cdennis3223/BarometerArray/barometer_PCB/mechanical/BarometerHousing.FCStd

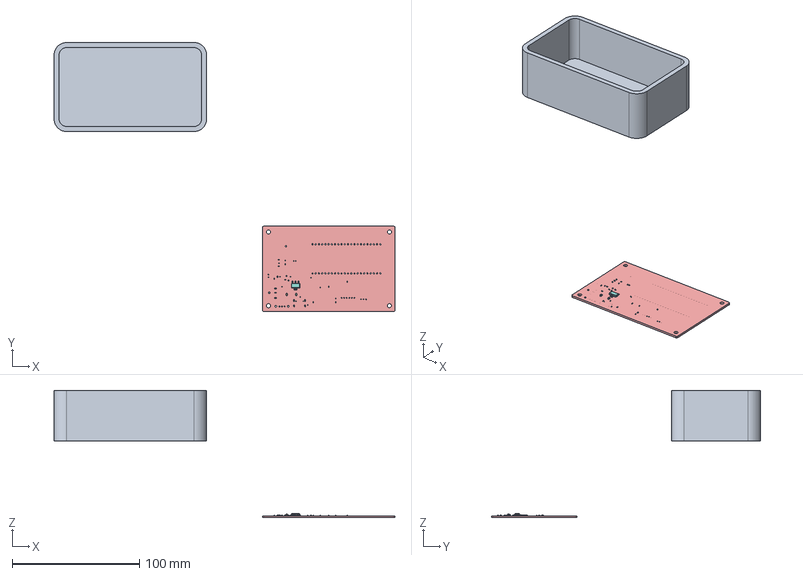
[picture p1: CAD file, 2026-03-30]
barometer_PCB/mechanical/BarometerHousing.FCStd
268.0 x 211.4 x 100.1 mm
R_0402_1005Metric
C_0402_1005Metric
D_SOD-323
R_0402_1005Metric001
C_0402_1005Metric001
R_0402_1005Metric002
R_0402_1005Metric003
R_0402_1005Metric004
LED_0402_1005Metric
C_0402_1005Metric002
R_0402_1005Metric005
C_0402_1005Metric003
R_0402_1005Metric006
C_0402_1005Metric004
SOT-223
R_0402_1005Metric007
R_0402_1005Metric008
C_0402_1005Metric005
R_0402_1005Metric009
R_0402_1005Metric010
R_0402_1005Metric011
L_0402_1005Metric
R_0402_1005Metric012
C_0402_1005Metric006
D_SOD-324
C_0402_1005Metric007
R_0402_1005Metric013
BarometricPressureSensor_PCB
