cdennis3223/BarometerArray/mechanical/Container-Lid.stl

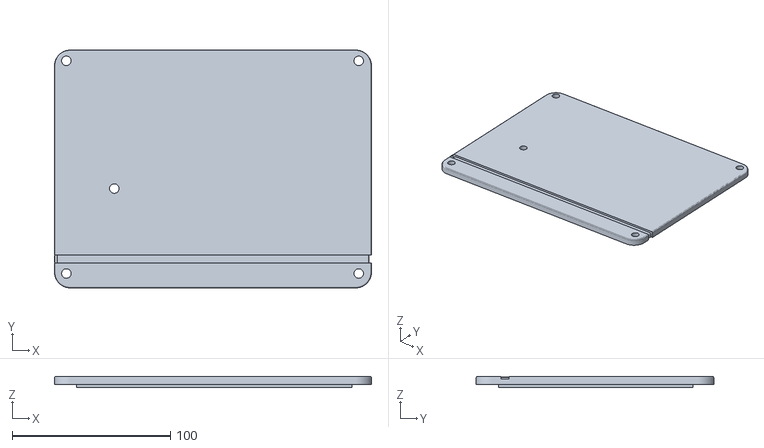
[picture p2: CAD file, 2026-04-27]
mechanical/Container-Lid.stl
200.1 x 150.1 x 7.00
