cdennis3223/BarometerArray/PCB/comp_STEPS/54-00125.step

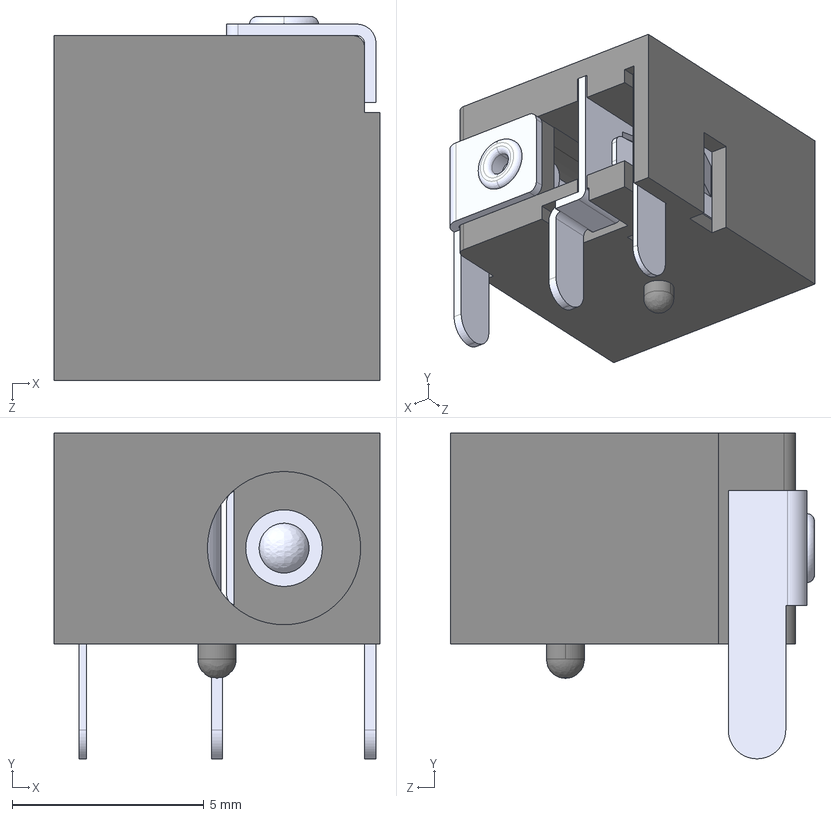
[picture p3: CAD file, 2026-04-01]
PCB/comp_STEPS/54-00125.step
8.50 x 8.50 x 9.50 mm
