cdennis3223/BarometerArray/PCB/PCB.step

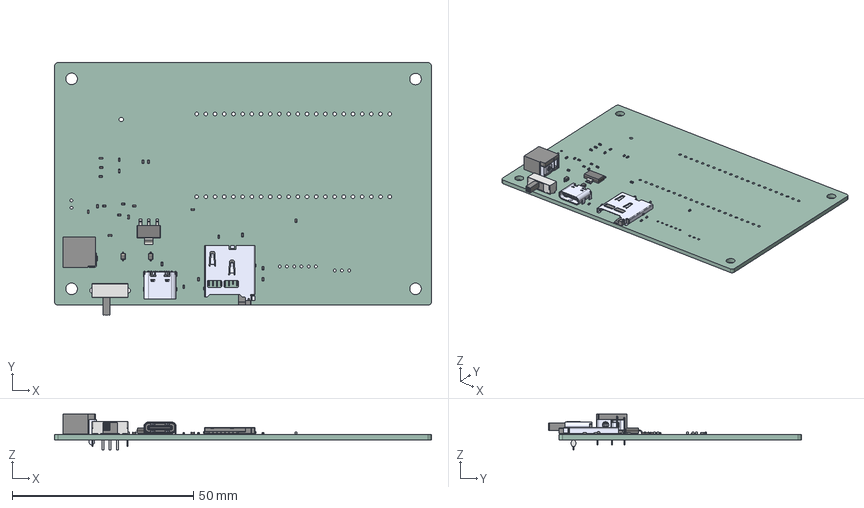
[picture p4: CAD file, 2026-04-01]
PCB/PCB.step
104.1 x 69.9 x 9.90 mm
R_0402_1005Metric x 14
C_0402_1005Metric x 8
D_SOD-323 x 2
LED_0402_1005Metric
GTFP08441BEU
SOT-223
EG1213
L_0402_1005Metric
USB4105GFA_USB4105GFA
BarometricPressureSensor_PCB
