cdennis3223/BarometerArray/PCB/Project Components/B2B_PH_K_S/B2B-PH-K-S.step

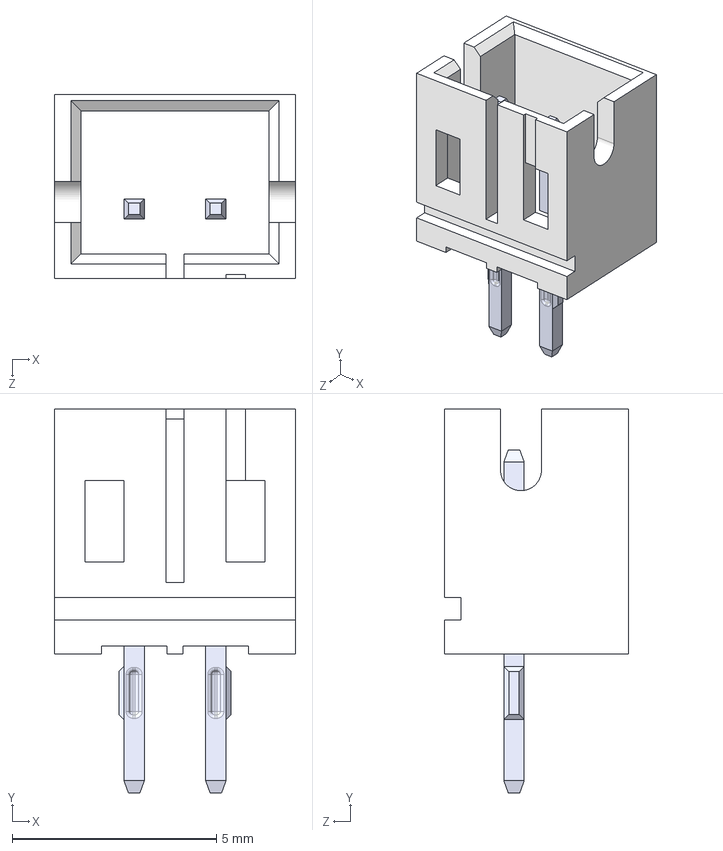
[picture p5: CAD file, 2026-03-30]
PCB/Project Components/B2B_PH_K_S/B2B-PH-K-S.step
5.90 x 9.40 x 4.50 mm
