cdennis3223/BarometerArray/PCB/Project Components/B3B_PH_K_S/B3B-PH-K-S.step

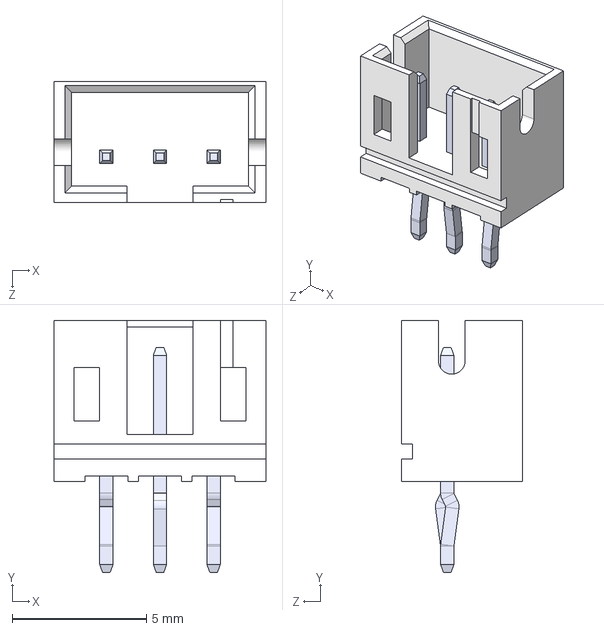
[picture p6: CAD file, 2026-03-30]
PCB/Project Components/B3B_PH_K_S/B3B-PH-K-S.step
7.90 x 9.40 x 4.50 mm
pin x 3
