cdennis3223/BarometerArray/PCB/Project Components/B6B_PH_K_S/B6B-PH-K-S.step

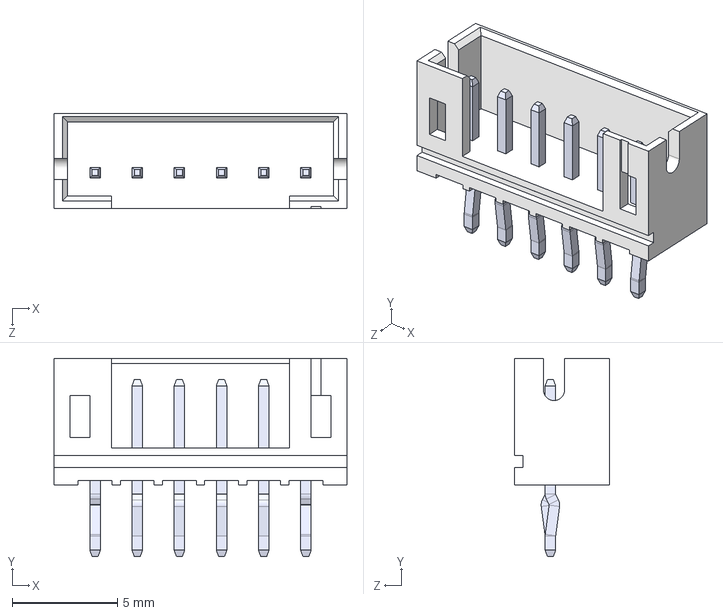
[picture p7: CAD file, 2026-03-30]
PCB/Project Components/B6B_PH_K_S/B6B-PH-K-S.step
13.9 x 9.40 x 4.50 mm
pin x 6
