cdennis3223/BarometerArray/PCB/Project Components/CD-PA1616D/CD-PA1616D.step

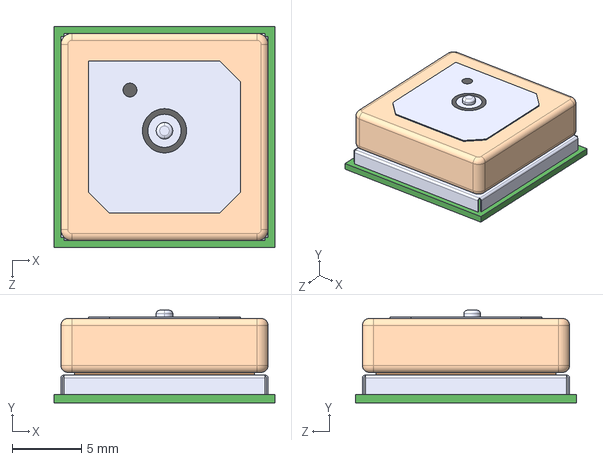
[picture p8: CAD file, 2026-03-30]
PCB/Project Components/CD-PA1616D/CD-PA1616D.step
16.0 x 6.70 x 16.0 mm
