cdennis3223/BarometerArray/PCB/Project Components/DPS368XTSA1/DPS368XTSA1.step

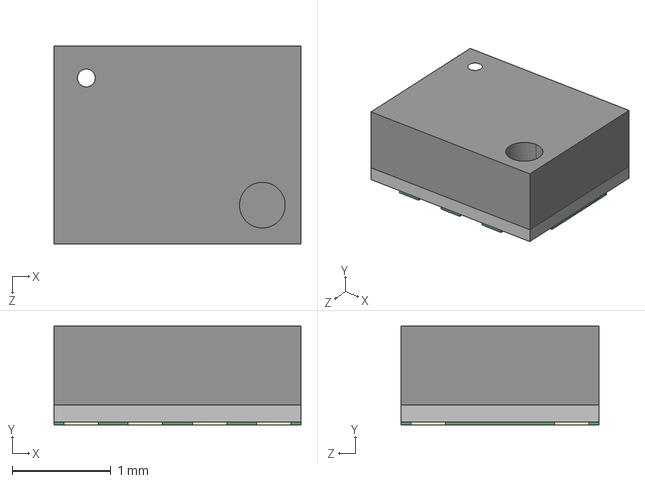
[picture p9: CAD file, 2026-03-30]
PCB/Project Components/DPS368XTSA1/DPS368XTSA1.step
2.50 x 1.00 x 2.00 mm
