cdennis3223/BarometerArray/PCB/Project Components/EG1218/EG1218.step

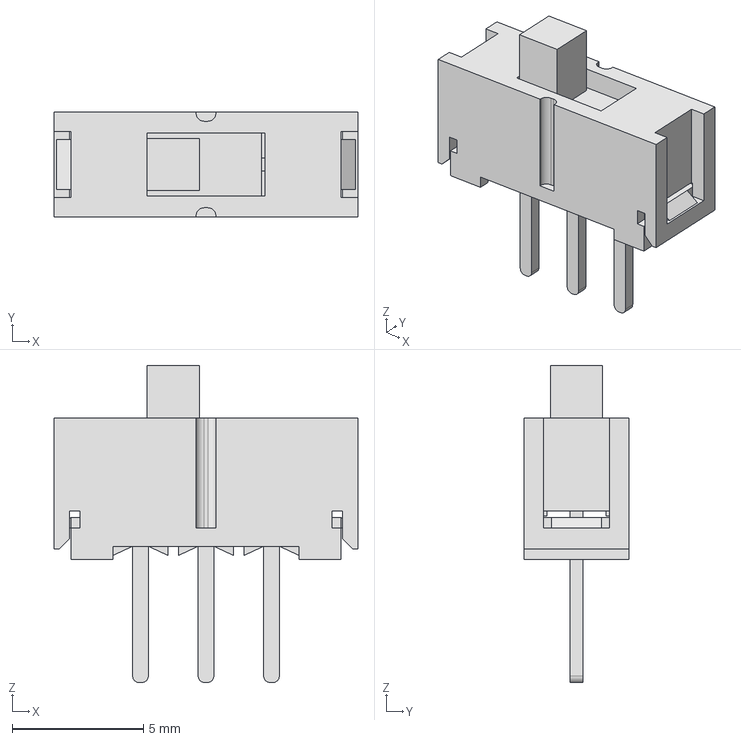
[picture p10: CAD file, 2026-03-30]
PCB/Project Components/EG1218/EG1218.step
11.6 x 4.00 x 12.1 mm
