cdennis3223/BarometerArray/PCB/Project Components/ESP32-S3-DEVKITC-1-N16R8V/ESP32-S3-DEVKITC-1-N16R8V.step

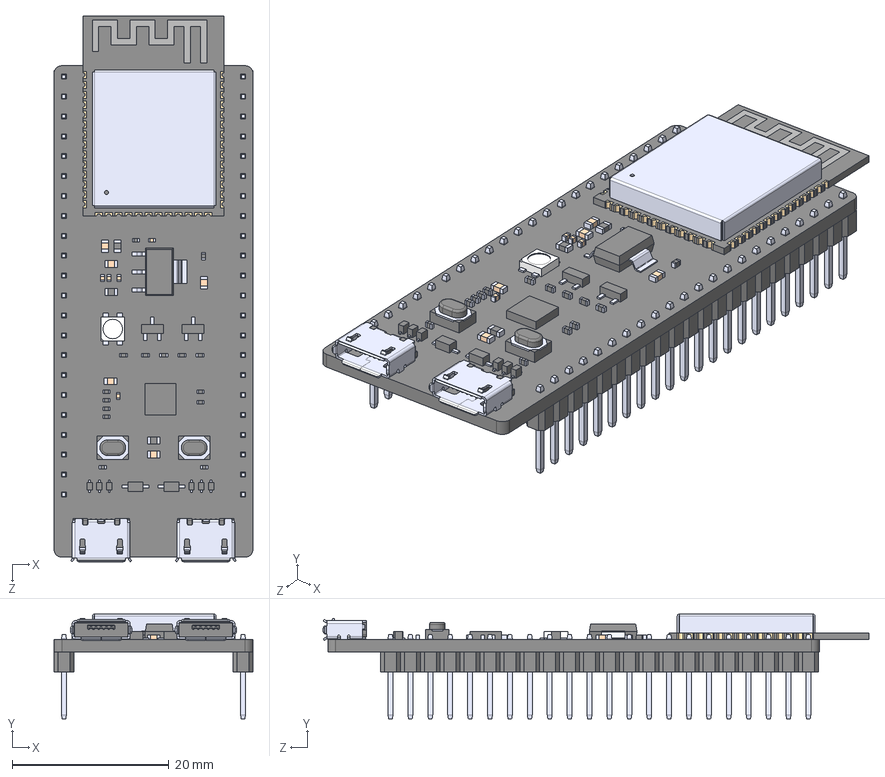
[picture p11: CAD file, 2026-03-30]
PCB/Project Components/ESP32-S3-DEVKITC-1-N16R8V/ESP32-S3-DEVKITC-1-N16R8V.step
25.4 x 13.4 x 69.6 mm
