cdennis3223/BarometerArray/PCB/Project Components/GTFP08441BEU/GTFP08441BEU.step

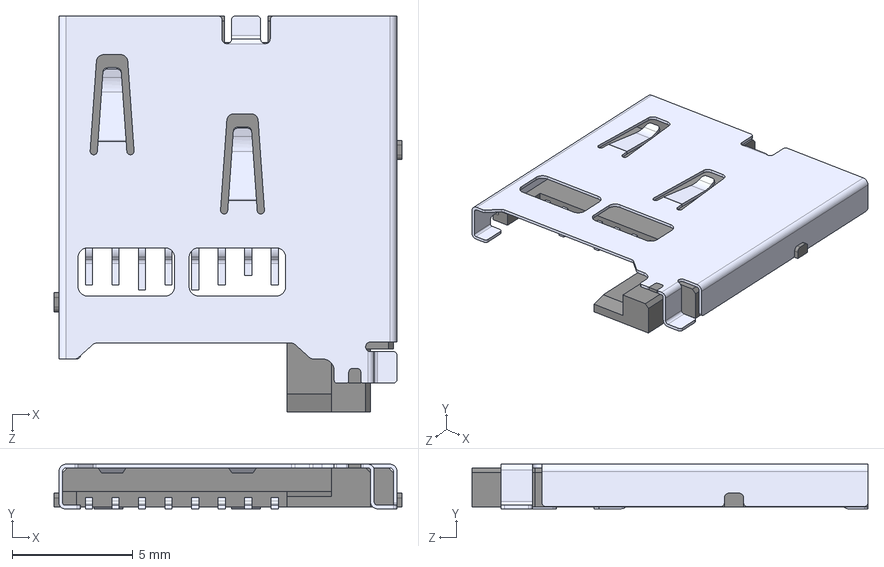
[picture p12: CAD file, 2026-03-30]
PCB/Project Components/GTFP08441BEU/GTFP08441BEU.step
14.4 x 1.85 x 16.4 mm
