cdennis3223/BarometerArray/PCB/Project Components/USB4105_GF_A/USB4105-GF-A.step

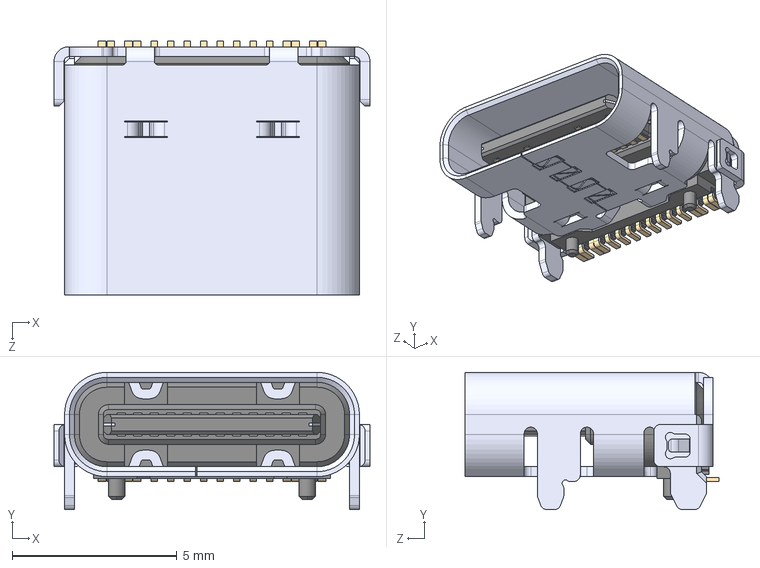
[picture p13: CAD file, 2026-03-30]
PCB/Project Components/USB4105_GF_A/USB4105-GF-A.step
9.58 x 4.16 x 7.71 mm
