cdennis3223/BarometerArray/mechanical/Container.FCStd

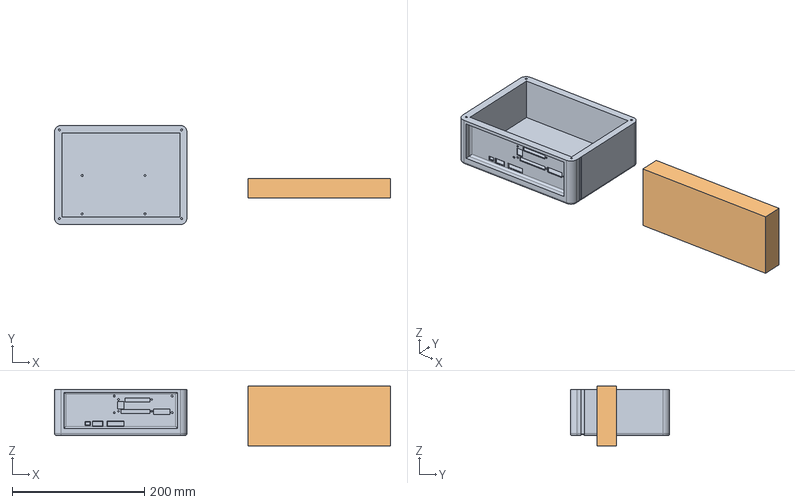
[picture p14: CAD file, 2026-04-27]
mechanical/Container.FCStd
507.5 x 150.0 x 90.0 mm
Container
FrontCap
