cdennis3223/BarometerArray/PCB/comp_STEPS/EG1213.STEP

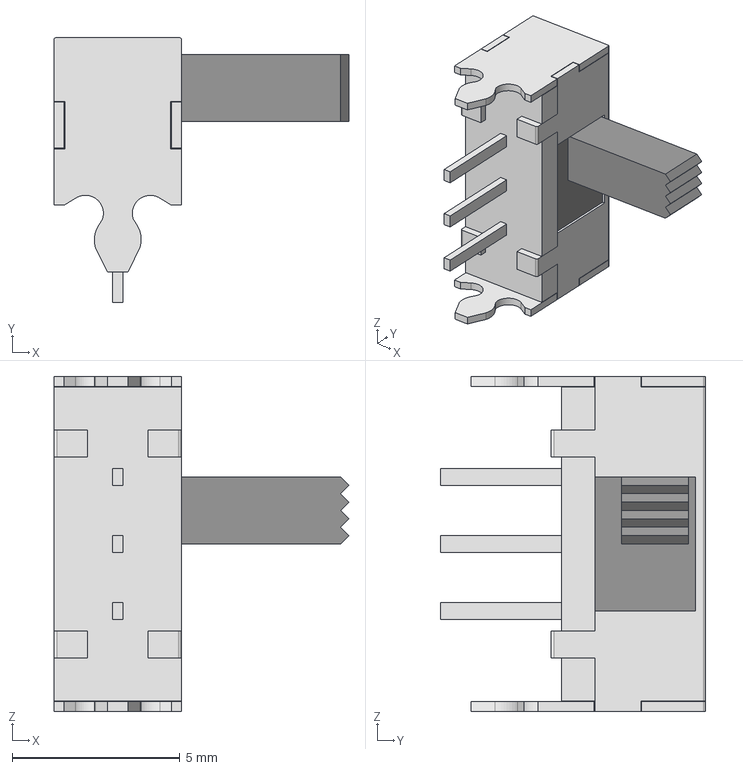
[picture p15: CAD file, 2026-03-30]
PCB/comp_STEPS/EG1213.STEP
8.80 x 7.90 x 10.00 mm
