cdennis3223/BarometerArray/mechanical/Container-Container.stl

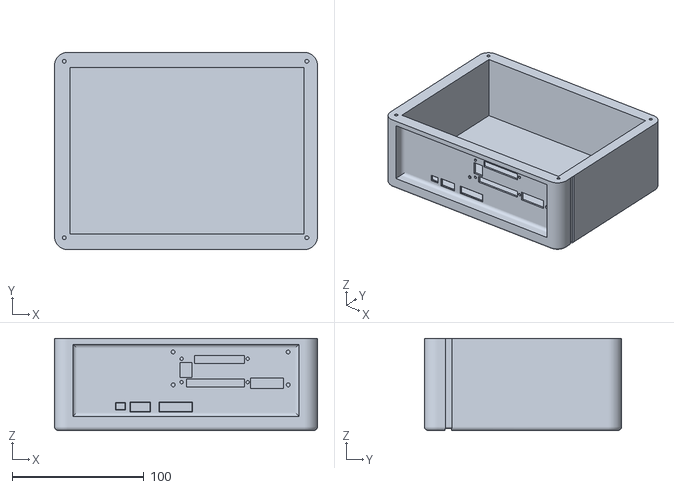
[picture p16: CAD file, 2026-04-27]
mechanical/Container-Container.stl
200.0 x 150.0 x 70.0
