cdennis3223/BarometerArray/PCB/comp_STEPS/USB4105-GF-A.STEP

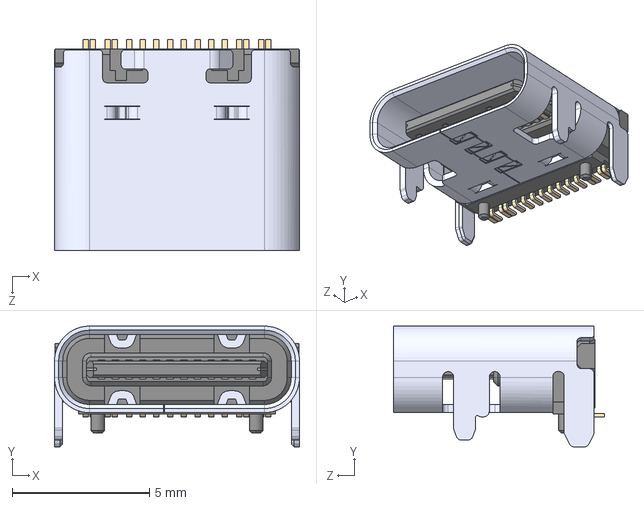
[picture p17: CAD file, 2026-03-30]
PCB/comp_STEPS/USB4105-GF-A.STEP
8.94 x 4.41 x 7.71 mm
