cdennis3223/BarometerArray/mechanical/Container-FrontCap.stl

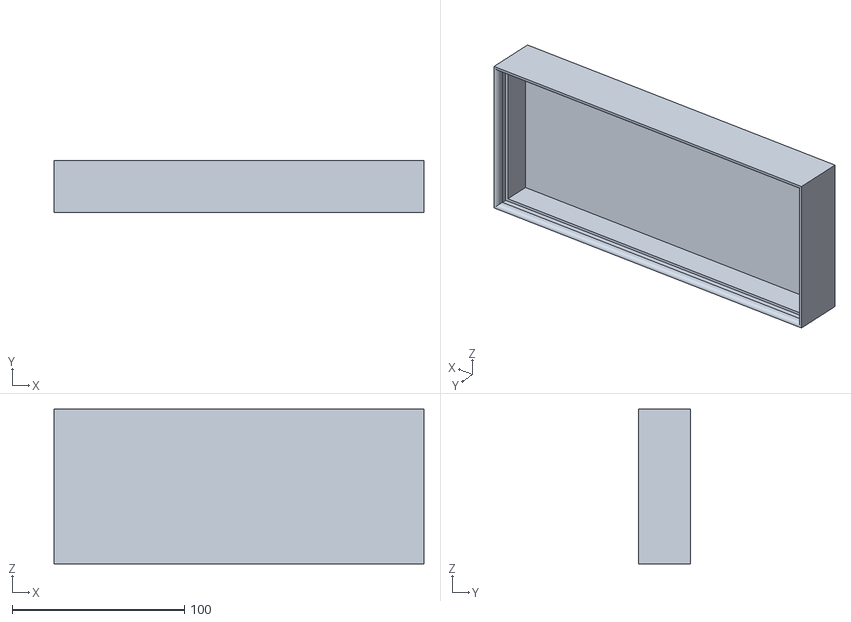
[picture p18: CAD file, 2026-04-27]
mechanical/Container-FrontCap.stl
215.0 x 30.0 x 90.0
