cdennis3223/BarometerArray/mechanical/BarometricPressureSensor.step

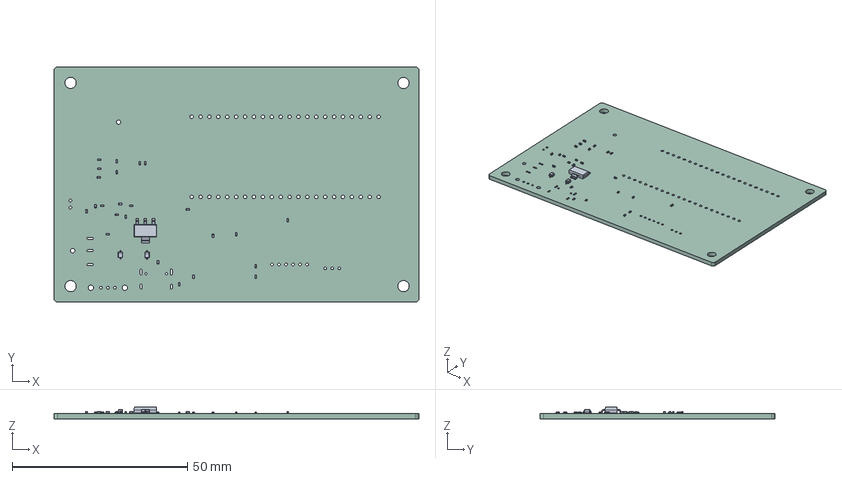
[picture p19: CAD file, 2026-03-30]
mechanical/BarometricPressureSensor.step
104.1 x 67.1 x 3.29 mm
R_0402_1005Metric x 14
C_0402_1005Metric x 8
D_SOD-323 x 2
LED_0402_1005Metric
SOT-223
L_0402_1005Metric
BarometricPressureSensor_PCB
