cdennis3223/BarometerArray/(list of files, cad)

Other CAD files:
PCB/Project Components/54-00125/54-00125.step
mechanical/Container-LidFillet026.stl
mechanical/BarometerHousing.FCStd
PCB/Project Components/MAX17048/MAX17048G_T10.step
PCB/Project Components/U.FL/2337019-1.step
