cdennis3223/BarometerArray/PCB/BarometricPressureSensor.kicad_pcb

## KiCad design PCB/BarometricPressureSensor.kicad_pcb (2026-04-27)

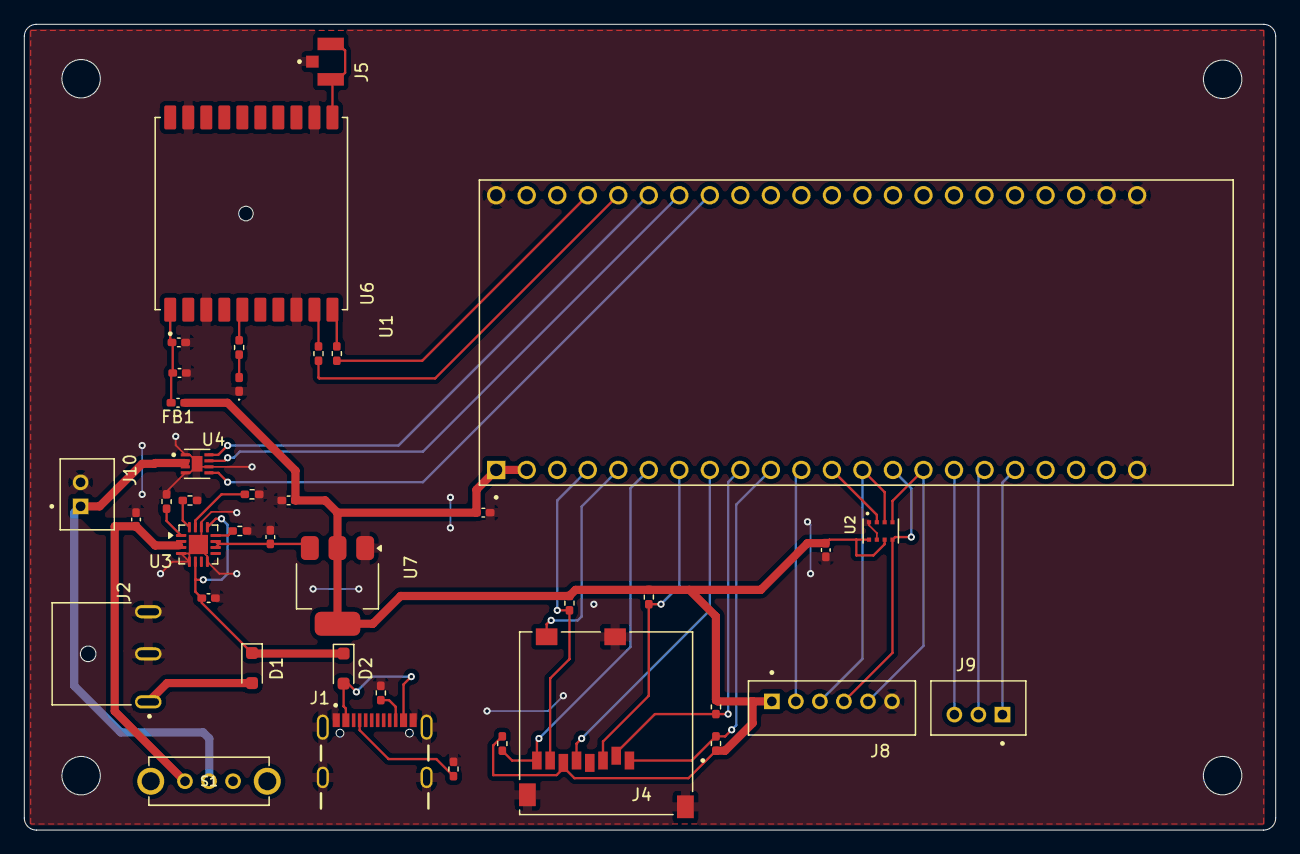
[picture p20: board BarometricPressureSensor.kicad_pcb from above]

Board: 2 copper layers, 104.1 x 67.1 mm, 40 parts (0 on the bottom side), 39 nets.

Parts:
C1, C3: 100nF; C_0402_1005Metric_Pad0.74x0.62mm_HandSolder
C2, C8: 10uF; C_0402_1005Metric_Pad0.74x0.62mm_HandSolder
C4, C7: 1uF; C_0402_1005Metric_Pad0.74x0.62mm_HandSolder
C5: 0.1uF; C_0402_1005Metric_Pad0.74x0.62mm_HandSolder
C6: 4.7uF; C_0402_1005Metric_Pad0.74x0.62mm_HandSolder
D1, D2: D_Schottky; D_SOD-323_HandSoldering
D3: LED; LED_0402_1005Metric_Pad0.77x0.64mm_HandSolder
FB1: FerriteBead_Small; L_0402_1005Metric_Pad0.77x0.64mm_HandSolder
J1: USB4105-GF-A; GCT_USB4105-GF-A
J2: 54-00125; TENSILITY_54-00125
J4: GTFP08441BEU; AMPHENOL_GTFP08441BEU
J5: 2337019-1; TE_2337019-1
J8: B6B-PH-K-S; JST_B6B-PH-K-S
J9: B3B-PH-K-S; JST_B3B-PH-K-S
J10: B2B-PH-K-S; JST_B2B-PH-K-S
R1, R2: 5.1k; R_0402_1005Metric_Pad0.72x0.64mm_HandSolder
R3, R7, R8, R9, R10, R11: 10k; R_0402_1005Metric_Pad0.72x0.64mm_HandSolder
R4, R6: 3k; R_0402_1005Metric_Pad0.72x0.64mm_HandSolder
R5: 300; R_0402_1005Metric_Pad0.72x0.64mm_HandSolder
R12, R13, R14: 470; R_0402_1005Metric_Pad0.72x0.64mm_HandSolder
S1: EG1213; SW_EG1213
U1: ESP32-S3-DEVKITC-1-N16R8V; XCVR_ESP32-S3-DEVKITC-1-N16R8V
U2: DPS368XTSA1; XDCR_DPS368XTSA1
U3: BQ24074RGT; VQFN-16-1EP_3x3mm_P0.5mm_EP1.6x1.6mm
U4: MAX17048G_T10; SON50P200X200X80-9N
U6: CD-PA1616D; XCVR_CD-PA1616D
U7: LD1117S33TR_SOT223; SOT-223-3_TabPin2

Connections:
+3V3: C2.1, C3.2, C8.1, FB1.1, J4.6 (VSS), J8.1, R7.1, R8.1, R9.1, R10.2, R11.2, U1.J1_1 (3V3), U1.J1_2 (3V3), U2.6 (VDDIO), U2.8 (VDD), U7.2 (VO)
+BATT: C6.1, J10.1, S1.1, S1.2, U3.2 (BAT), U3.3 (BAT), U4.2 (CELL), U4.3 (VDD)
/CMD: J4.3 (CMD), R7.2, U1.J1_7 (GPIO7)
/CS1: U1.J1_12 (GPIO8), U2.2 (CSB)
/CS2: J8.2, U1.J1_11 (GPIO18)
/D0: J4.7 (DAT0), R11.1, U1.J1_4 (GPIO4)
/D1: J4.8 (DAT1), R10.1, U1.J1_6 (GPIO6)
/D2: J4.1 (DAT2), R8.2, U1.J1_10 (GPIO17)
/D3: J4.2 (CD/DAT3), R9.2, U1.J1_9 (GPIO16)
/DPSCLK: J8.5, U1.J1_15 (GPIO9), U2.4 (SCK)
/DPSMISO: J8.4, U1.J1_14 (GPIO46), U2.5 (SDO)
/DPSMOSI: J8.3, U1.J1_13 (GPIO3), U2.3 (SDI)
/GPSRX: R13.1, U1.J3_5 (GPIO2)
/GPSTX: R14.1, U1.J3_4 (GPIO1)
/IN: C7.1, D1.1 (K), D2.1 (K), U3.6 (EN1), U3.13 (IN)
/MAXALRT: U1.J3_8 (MTDO/GPIO40), U4.5 (~ALERT)
/MAXSCL: U1.J3_7 (MTDI/GPIO41), U4.7 (SCL)
/MAXSDA: U1.J3_6 (MTMS/GPIO42), U4.8 (SDA)
/OLEDBUT: J9.3, U1.J1_16 (GPIO10)
/OLEDSCL: J9.2, U1.J1_17 (GPIO11)
/OLEDSDA: J9.1, U1.J1_18 (GPIO12)
/SDCLK: J4.5 (CLK), U1.J1_8 (GPIO15)
/SDDET: J4.CD_PIN, U1.J1_5 (GPIO5)
GND: C1.2, C2.2, C3.1, C4.2, C5.2, C6.2, C7.2, C8.2, D3.1 (K), J1.A1_B12 (GND), J1.B1_A12 (GND__1), J1.SH1 (SHELL_GND), J1.SH2 (SHELL_GND__1), J1.SH3 (SHELL_GND__2), J1.SH4 (SHELL_GND__3), J2.B, J2.C, J4.G1 (SHIELD_GND), J4.G2 (SHIELD_GND__1), J4.G3 (SHIELD_GND__2), J5.1, J8.6, J10.2, R1.2, R2.2, R3.2, R4.1, R5.1, R6.1, U1.J1_22 (GND), U1.J3_1 (GND), U1.J3_21 (GND), U1.J3_22 (GND), U2.1 (GND), U2.7 (GND), U3.4 (~CE), U3.5 (EN2), U3.8 (VSS), U3.14 (TMR), U3.17 (VSS), U4.1 (CTG), U4.4 (GND), U4.6 (QSTRT), U4.9 (EP), U6.3 (GND), U6.8 (GND), U6.12 (GND), U6.19 (GND), U7.1 (GND)
unnamed: D1.2 (A), J2.A
unnamed: D2.2 (A), J1.A4_B9 (VBUS), J1.B4_A9 (VBUS__1)
unnamed: D3.2 (A), R12.2
unnamed: J1.A5 (CC1), R1.1
unnamed: J1.B5 (CC2), R2.1
unnamed: R6.2, U3.12 (ILIM)
unnamed: R4.2, U3.16 (ISET)
unnamed: R5.2, U3.15 (ITERM)
unnamed: R3.1, U3.1 (TS)
unnamed: R12.1, U6.5 (3D-FIX)
unnamed: J5.G1, J5.G2, U6.11 (EX_ANT)
unnamed: R14.2, U6.10 (RX)
unnamed: R13.2, U6.9 (TX)
unnamed: C4.1, C5.1, FB1.2, U6.1 (VCC)
unnamed: C1.1, U3.10 (OUT), U3.11 (OUT), U7.3 (VI)
