cdennis3223/BarometerArray/PCB/UserInterface.kicad_pcb

## KiCad design PCB/UserInterface.kicad_pcb (2026-03-12)

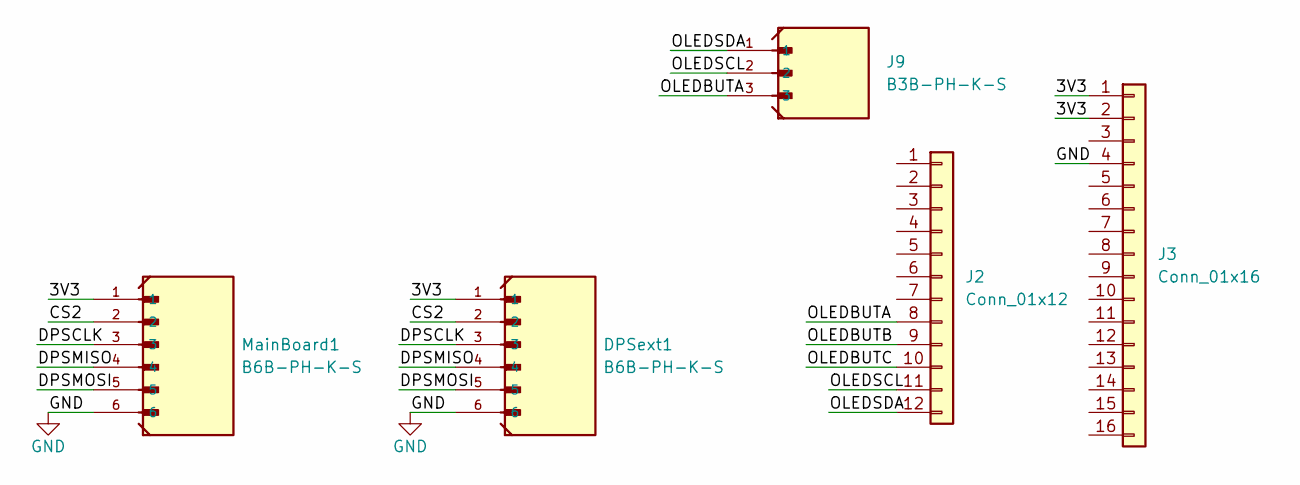
[picture p21: schematic UserInterface.kicad_sch]

Parts:
DPSext1: B6B-PH-K-S; JST_B6B-PH-K-S
J2: Conn_01x12; PinSocket_1x12_P2.54mm_Vertical
J3: Conn_01x16; PinSocket_1x16_P2.54mm_Vertical
J9: B3B-PH-K-S; JST_B3B-PH-K-S
MainBoard1: B6B-PH-K-S; JST_B6B-PH-K-S

Connections:
/3V3: DPSext1.1, J3.1, J3.2, MainBoard1.1
/CS2: DPSext1.2, MainBoard1.2
/DPSCLK: DPSext1.3, MainBoard1.3
/DPSMISO: DPSext1.4, MainBoard1.4
/DPSMOSI: DPSext1.5, MainBoard1.5
/OLEDBUTA: J2.8, J9.3
/OLEDBUTB: J2.9
/OLEDBUTC: J2.10
/OLEDSCL: J2.11, J9.2
/OLEDSDA: J2.12, J9.1
GND: DPSext1.6, J3.4, MainBoard1.6

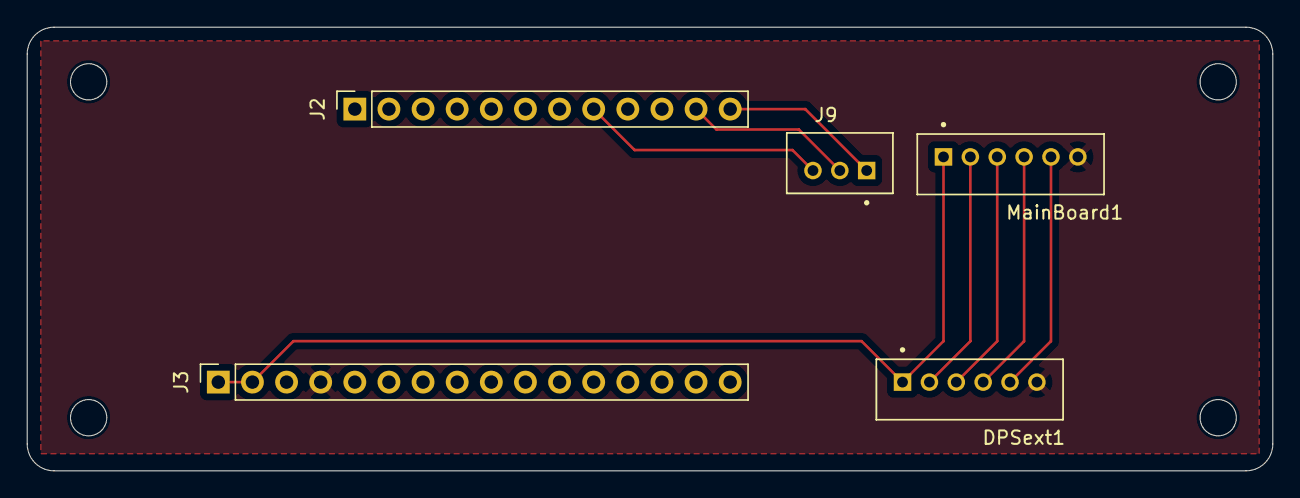
[picture p22: board UserInterface.kicad_pcb from above]

Board: 2 copper layers, 92.7 x 33.0 mm, 5 parts (0 on the bottom side), 9 nets.
