cdennis3223/BarometerArray/PCB/ExtDPS368.kicad_pcb

## KiCad design PCB/ExtDPS368.kicad_pcb (2026-03-09)

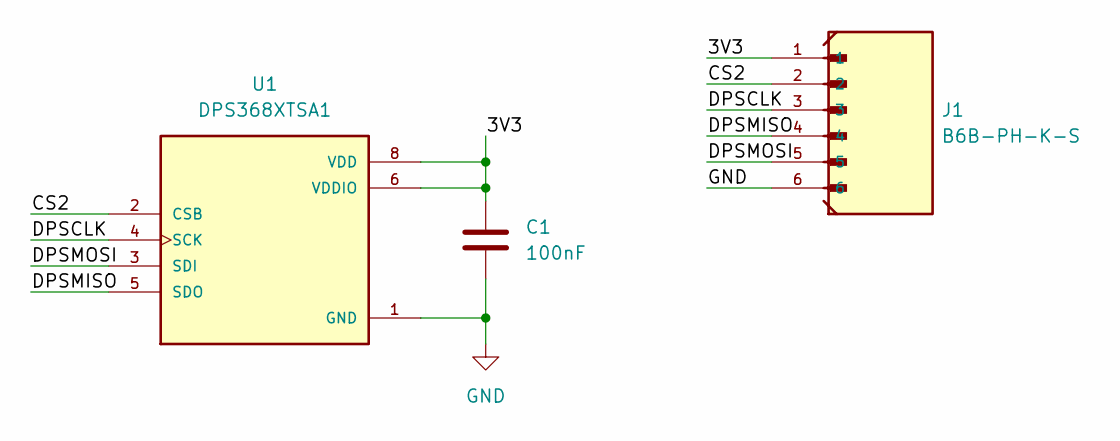
[picture p23: schematic ExtDPS368.kicad_sch]

Parts:
C1: 100nF; C_0402_1005Metric_Pad0.74x0.62mm_HandSolder
J1: B6B-PH-K-S; JST_B6B-PH-K-S
U1: DPS368XTSA1; XDCR_DPS368XTSA1

Connections:
/3V3: C1.1, J1.1, U1.6 (VDDIO), U1.8 (VDD)
/CS2: J1.2, U1.2 (CSB)
/DPSCLK: J1.3, U1.4 (SCK)
/DPSMISO: J1.4, U1.5 (SDO)
/DPSMOSI: J1.5, U1.3 (SDI)
GND: C1.2, J1.6, U1.1 (GND), U1.7 (GND)

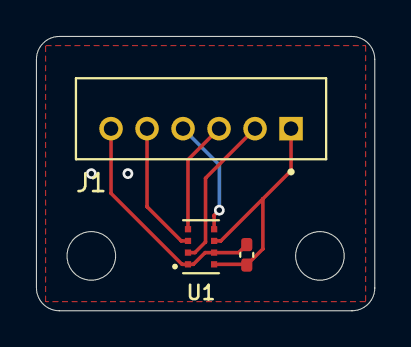
[picture p24: board ExtDPS368.kicad_pcb from above]

Board: 2 copper layers, 18.8 x 15.2 mm, 3 parts (0 on the bottom side), 6 nets.
