cdennis3223/BarometerArray/firmware/include/SD.h

#pragma once

#include "esp_log.h"
#include "driver/gpio.h"
#include "GPS.h"
#include "collate.h"

//Define all GPIO pins for SD Card
#define SD_CLK_PIN 15
#define SD_CMD_PIN 7
#define SD_D0_PIN 4
#define SD_D1_PIN 6
#define SD_D2_PIN 17
#define SD_D3_PIN 16
#define DETECT_PIN 5

#define MOUNT_POINT "/sdcard"

esp_err_t sd_init(void);

esp_err_t sd_deinit(void);

esp_err_t sd_log_open(const char *name, const char *mode);

esp_err_t sd_log_sample(const sample_t *s);

void sd_log_close(void);

//for the button task in screen.c to view sd status
bool sd_is_mounted(void);

bool sd_is_logging(void);
