cdennis3223/BarometerArray/(commit log)

2026-02-05 I think I have established communication with the pressure sensor. However I am just printing a serial number currently.
2026-02-09 The MISO and SCLK lines are working however the SDO of the DPS is not working. There seems to be a vague square wave but it is small and malformed
    [DPS.c, DPS.h, main.c]
2026-02-11 Fixed the Coefficient Values
    [DPS.c, DPS.h, main.c]
2026-02-11 Updated Coefficients and corrected Temperature and pressure equations
    [DPS.c, DPS.h, main.c]
2026-02-11 Currently Trying to debug Scaling issue with pressure and temperature output
    [DPS.c, DPS.h, main.c]
2026-02-13 Working DPS Sensor, still finalizing initialization
2026-02-16 working Code for DPS Sensor, All initialization in the DPS.c file.
2026-02-27 clean code that prints horizontal!
2026-03-02 worked on encapsulating functions from main to DPS.c pressure sensor modules, good progress, code is cleaner still needs some work
2026-03-03 better organized the code for the pressure sensor module
2026-03-06 Reorganized repo: firmware files moved into firmware folder and added a PCB and mechanical folder
2026-03-06 new folders were not added to remote because they were empth, I fixed the issue by adding .gitkeep files within PCB and mechanical folders
2026-03-11 Add files via upload
    Updated the switch we are using for the PCB. Will need to order these switches on our own.
    [BarometricPressureSensor.kicad_pcb, BarometricPressureSensor.kicad_sch]
2026-03-12 Add files via upload
    Updated Sizing on User Interface
    [UserInterface.kicad_pcb, UserInterface.kicad_sch]
2026-03-21 created a new collate module that implements a ring buffer to store timestamped measurements from the DPS368 pressure sensor before pushing it to the SD card. There is a task that runs in collate.c t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
2026-03-23 Updated BatMGMT.c and .h files with potentially working I2C, need to test still
2026-03-30 added 3D models for USB, SD Card module, and switch components of mainboard in PCB design
    [BarometricPressureSensor.kicad_pcb, EG1213.STEP, GTFP08441BEU.STEP, USB4105-GF-A.STEP]
2026-03-30 saving all changes before merging
    [2337019-1.step, 54-00125.step, B2B-PH-K-S.step, B3B-PH-K-S.step, B6B-PH-K-S.step, BarometerHousing.FCStd, BarometricPressureSensor.kicad_pcb, BarometricPressureSensor.step]
2026-03-30 added button functionality for cycling through screen readouts
2026-04-01 Add files via upload
    The current state of the container design, with a "Lid" That is in design still
    [Container.FCStd]
2026-04-01 Added another component and renamed PCB.step, updated Lid to make container smoother
    [54-00125.step, Container.FCStd, PCB.step]
2026-04-03 Add files via upload
    Updated Container design and added the front cap to it.
    [Container.FCStd]
2026-04-06 Added GPS timestamping to pressure sample ring buffer, program now timestamps samples and prints them to the serial, next steps are adding PPS synchronization and then saving to SD card
2026-04-08 Added all passthrough holes for user interface, and added mounting holes for PCB inside case and fixed front cap, might be ready to print a prototype.
    [Container.FCStd]
2026-04-08 fixed errors in BatMGMT module that caused compiler to fail
    [BatMGMT.c, BatMGMT.h]
2026-04-08 Updated .h files to match PCB
2026-04-08 Updated the platformio.ini file and fixed BatMGT.h error
    [BatMGMT.h]
2026-04-16 Working SD writes and Battery Management code
2026-04-16 Updated init for DPS to 32Hz for pressure and temp measurements
    [BarometricPressureSensor-B_Cu.gbr, BarometricPressureSensor-B_Mask.gbr, BarometricPressureSensor-B_Paste.gbr, BarometricPressureSensor-B_Silkscreen.gbr, BarometricPressureSensor-Edge_Cuts.gbr, BarometricPressureSensor-F_Cu.gbr, BarometricPressureSensor-F_Mask.gbr, BarometricPressureSensor-F_Paste.gbr]
2026-04-17 Updated Logger task, main is currently in development
2026-04-19 Added functionaliity to UI, now can view GPS data(longitude, latitude, UTC) and Pressure Sensor Data(pressure and temp)
2026-04-19 Added a global watch file for shutdown tasks, added long and short button press on OLED screen and shutdown procedures for collate and logger tasks.
    [collate.c, logger.c, main.c, screen.c, screen.h]
2026-04-19 added battery status to user interface display
2026-04-19 Final commit of the night, updated GPS with some potential PPS functionality, updated logger to have UTC time and ESP time columns and a valid column for GPS fix
    [GPS.c, GPS.h, GPS_parser.c, GPS_parser.h, SD.c, SD.h, collate.c, collate.h]
2026-04-20 added SD status to user interface, fixed problem with GPS data not displaying on screen
    [GPS.c, SD.c, SD.h, screen.c]
2026-04-20 added battery volage back to logging, added comments to logger.c, cleaned main.c
2026-04-22 Updated logger to log real time in YYYY MM DD MM SS.SSS and added more decimal places to pressure samples
2026-04-27 Add files via upload
    Updated PPS and SD Schematic
    [BarometricPressureSensor.kicad_sch]
2026-04-27 Annotated main board schematic, corrected switch short on main PCB
    [BarometricPressureSensor.kicad_pcb, BarometricPressureSensor.kicad_sch]
2026-04-27 Add files via upload
    Container version 2!
    [Container-Container.stl, Container-FrontCap.stl, Container-Lid.stl, Container.FCStd]
2026-04-30 fixed bug with pressure not being displayed without SD inserted, improved user interface
    [SD.c, collate.c, screen.c]
2026-04-30 fixed overflow issue with millisecond field of sample_t struct
    [GPS_parser.c, SD.c, collate.h]
2026-05-02 fixed issue with millisecond NMEA timestamp, added some comments
    [GPS.c, GPS.h, collate.c]
2026-05-02 fixed PPS synchronization issues, PPS sync appears to work without any issue now
    [GPS.c, GPS.h]
2026-05-02 fixed PPS and NMEA timing coordination problem, viewed log csv files, looks fixed now, made other small improvements to code
    [BatMGMT.c, GPS.c, GPS.h, GPS_parser.h, collate.c, main.c, screen.c]
2026-05-05 broke main board schematic into smaller schematics, annotated and organized
    [MainBoard.kicad_sch, Power_Management.kicad_sch, Sensors.kicad_sch, outputs.kicad_sch]
2026-05-08 implemented external dps sensor
2026-05-08 Updated Screen to show both pressure and temperature measurements
